ellenfel/solar_tracker_pcb/kicad_files/doc/screenshots/revd/3d-model-front.png

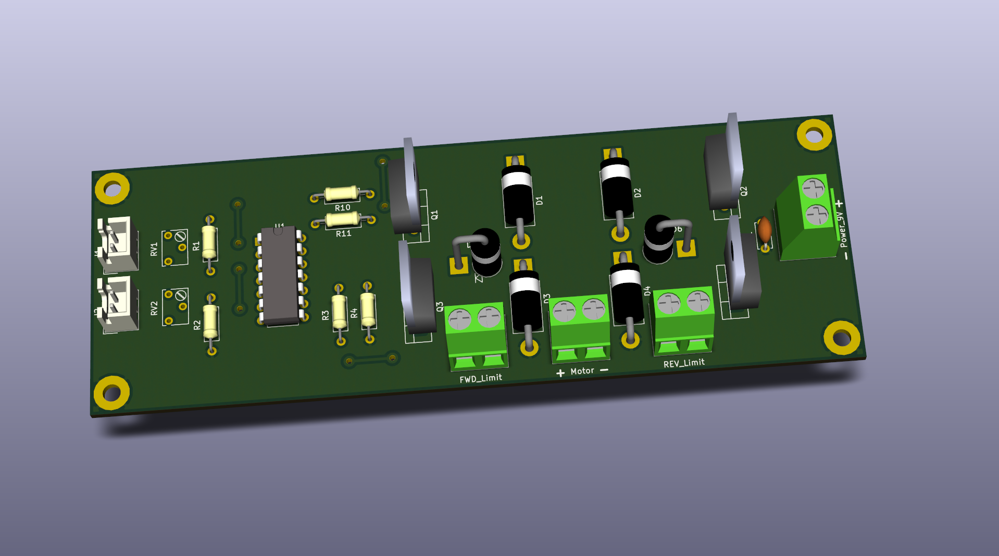
kicad_files/doc/screenshots/revd/3d-model-front.png
