ellenfel/solar_tracker_pcb/3d-model-bottom.png

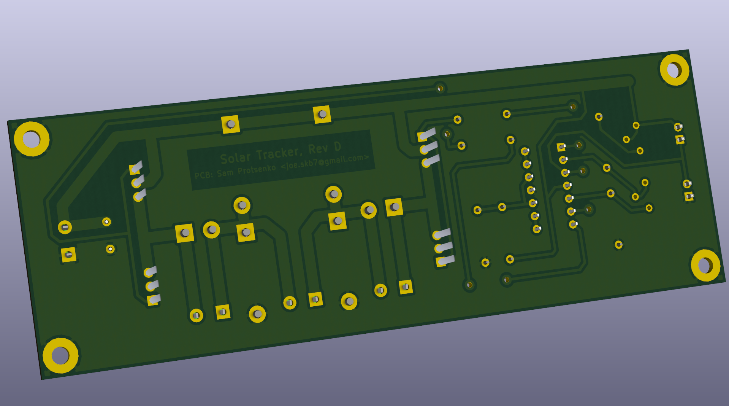
3d-model-bottom.png
