ellenfel/solar_tracker_pcb/diy_solar_tracker_schematic.png

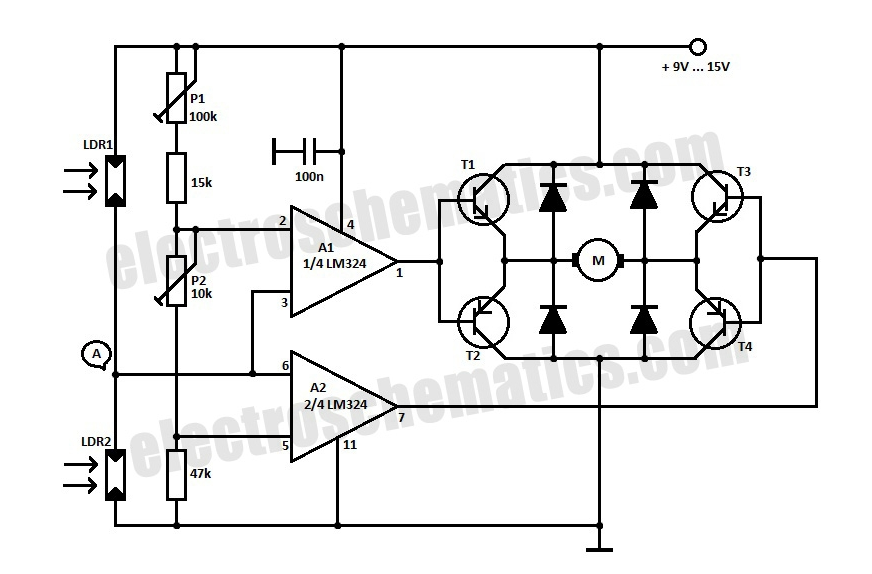
diy_solar_tracker_schematic.png
