ellenfel/solar_tracker_pcb/kicad_files/doc/limit-switch/limit-switch-1.png

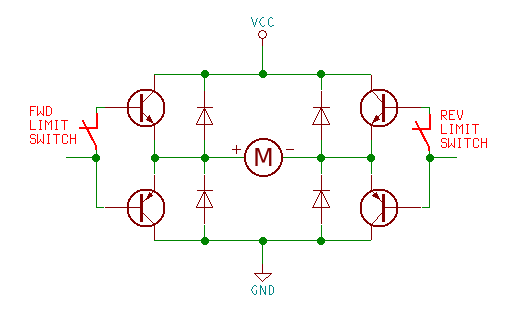
kicad_files/doc/limit-switch/limit-switch-1.png
