ellenfel/solar_tracker_pcb/kicad_files/doc/limit-switch/limit-switch-2.png

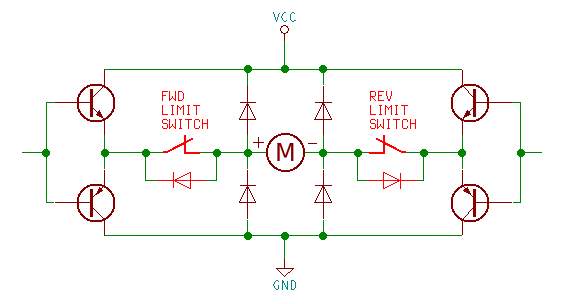
kicad_files/doc/limit-switch/limit-switch-2.png
