ellenfel/solar_tracker_pcb/kicad_files/doc/scheme.jpg

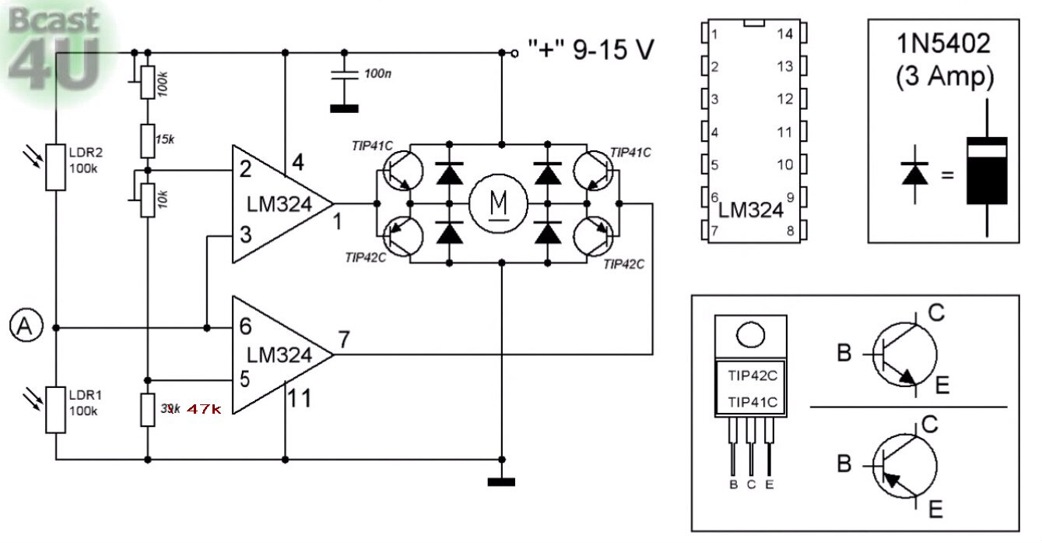
kicad_files/doc/scheme.jpg
