ellenfel/solar_tracker_pcb/kicad_files/doc/screenshots/revd/schematic.png

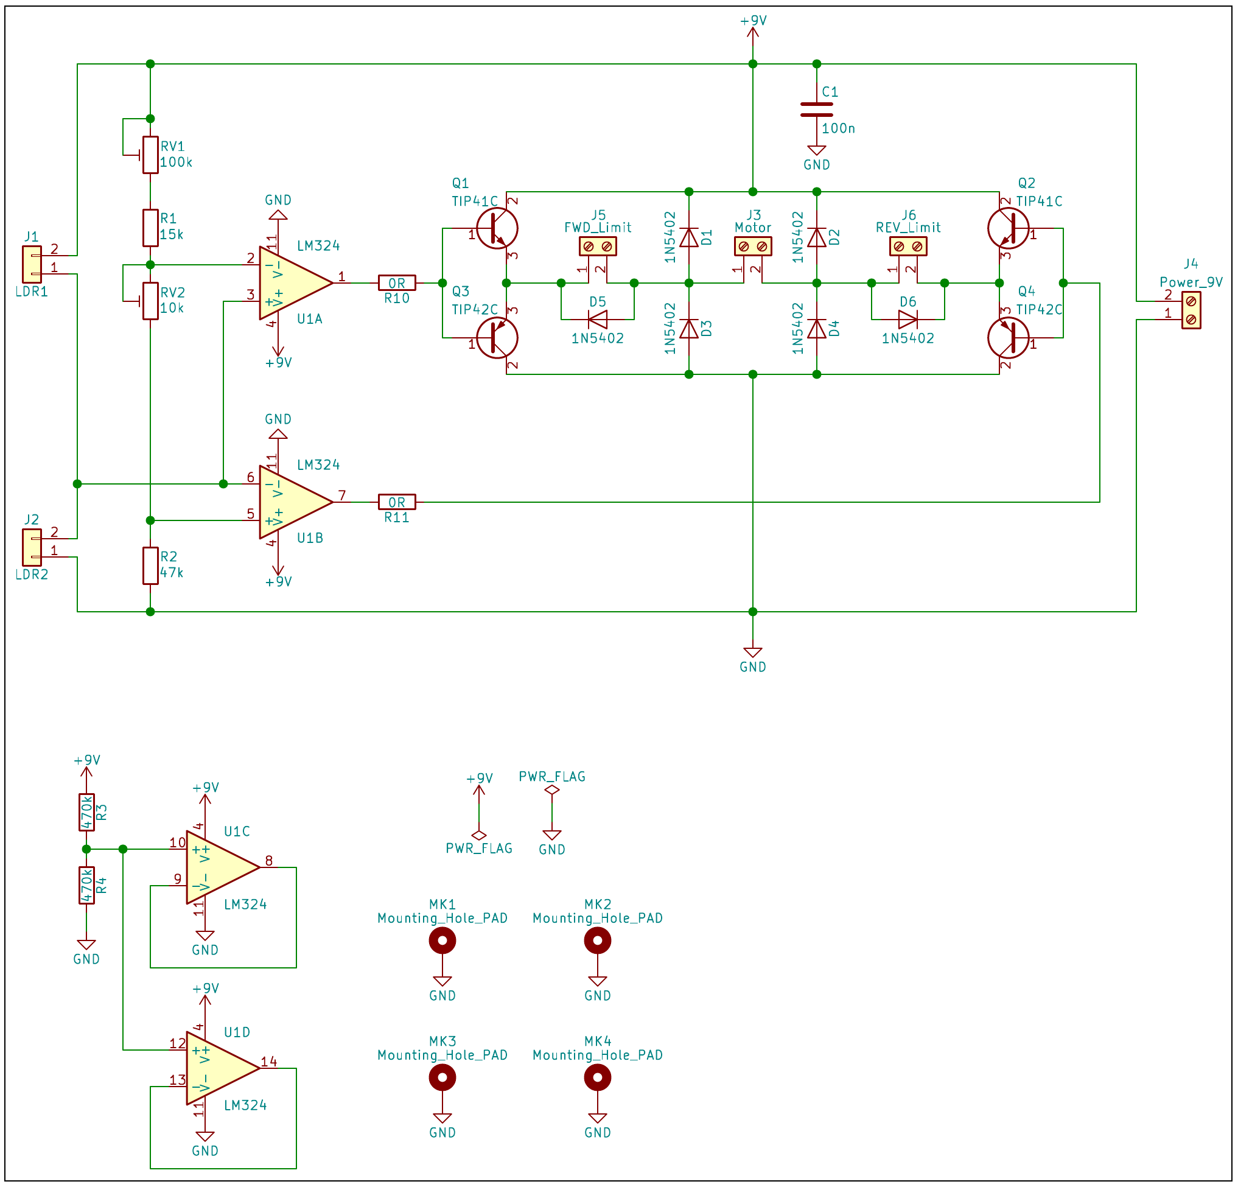
kicad_files/doc/screenshots/revd/schematic.png
