ellenfel/solar_tracker_pcb/Screenshot from 2024-11-24 20-09-38.png

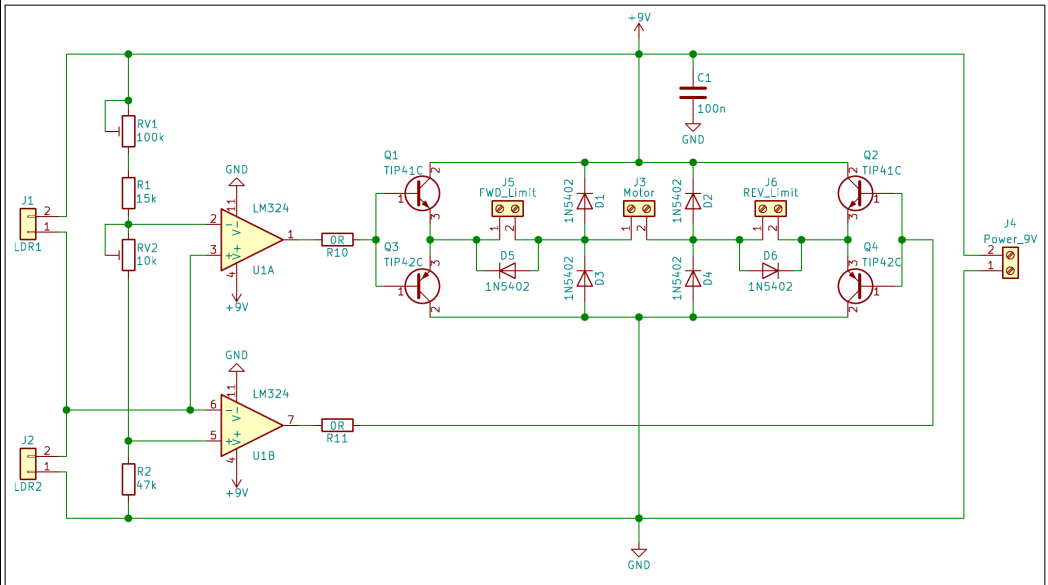
Screenshot from 2024-11-24 20-09-38.png
