ellenfel/solar_tracker_pcb/Screenshot from 2024-11-24 20-09-58.png

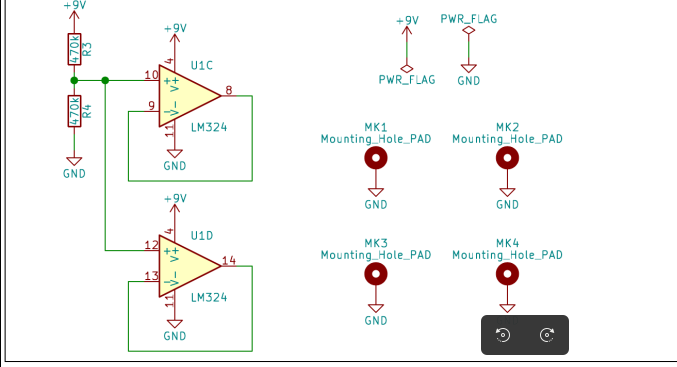
Screenshot from 2024-11-24 20-09-58.png
