ellenfel/solar_tracker_pcb/solar.png

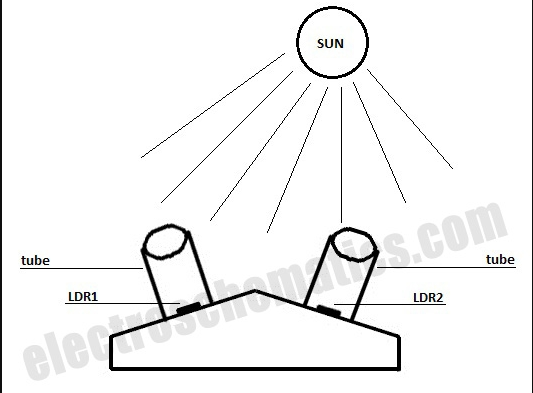
solar.png
