ellenfel/solar_tracker_pcb/kicad_files/out/revd/bom.pdf

solar-tracker

Id | Designator | Package | Quantity | Designation
1 C1 | | C_Disc_D5.0mm_W2.5mm_P5.00mm | 1 100n
2 D1-D6 | | D_DO-201AD_P15.24mm_Horizontal | 6
3 J1,J2 | | JST_XH_B02B-XH-A_02x2.50mm_Straight | 2
4 J3-J6 | | TerminalBlock_Pheonix_MKDS1.5-2pol | 4
5 Q1,Q2 | | TO-220_Vertical | 2 TIP41C
6 Q3,Q4 | | TO-220_Vertical | 2 TIP42C
7 R1 | | R_Axial_DIN0207_L6.3mm_D2.5mm_P10.16mm_Horizontal | 1 15k
8 R10,R11 | | R_Axial_DIN0207_L6.3mm_D2.5mm_P10.16mm_Horizontal | 2 0R
9 R2 | | R_Axial_DIN0207_L6.3mm_D2.5mm_P10.16mm_Horizontal | 1 47k
10 R3,R4 | | R_Axial_DIN0207_L6.3mm_D2.5mm_P10.16mm_Horizontal | 2 470k
11 RV1 | | Potentiometer_Trimmer_Bourns_3266W | 1 100k
12 RV2 | | Potentiometer_Trimmer_Bourns_3266W | 1 10k
13 U1 | | DIP-14_W7.62mm | 1 LM324
