ellenfel/solar_tracker_pcb/kicad_files/solar-tracker.kicad_pcb

## KiCad design kicad_files/solar-tracker.kicad_pcb (2024-11-24)

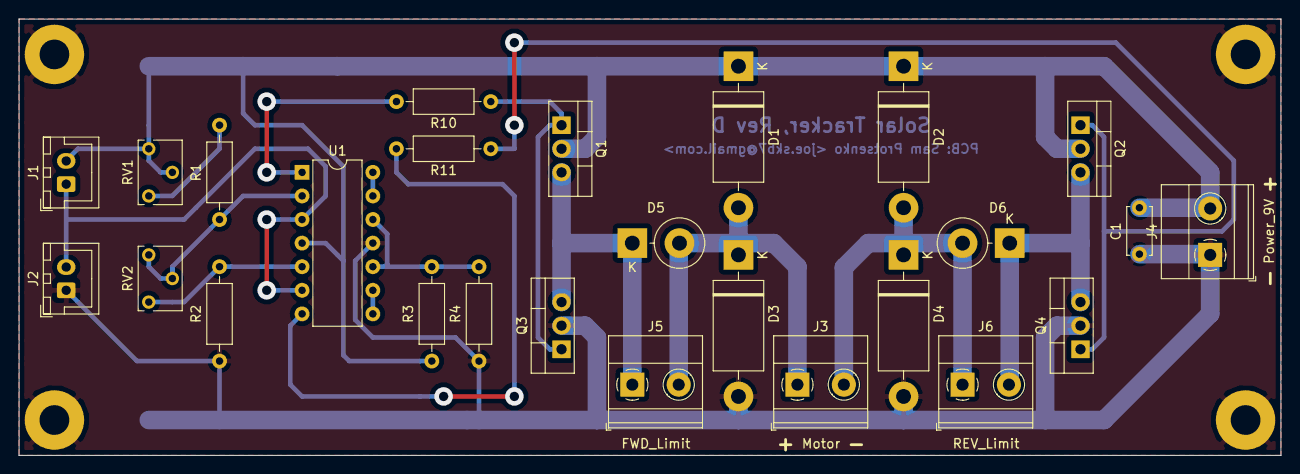
[picture p11: board solar-tracker.kicad_pcb from above]

Board: 2 copper layers, 135.9 x 47.0 mm, 30 parts (0 on the bottom side), 17 nets.

Parts:
C1: 100n; C_Disc_D5.0mm_W2.5mm_P5.00mm
D1, D2, D3, D4: 1N5402; D_DO-201AD_P15.24mm_Horizontal
D5, D6: 1N5402; D_DO-201AD_P5.08mm_Vertical_KathodeUp
J1: LDR1; JST_XH_B02B-XH-A_1x02_P2.50mm_Vertical
J2: LDR2; JST_XH_B02B-XH-A_1x02_P2.50mm_Vertical
J3: Motor; TerminalBlock_Phoenix_MKDS-1,5-2_1x02_P5.00mm_Horizontal
J4: Power_9V; TerminalBlock_Phoenix_MKDS-1,5-2_1x02_P5.00mm_Horizontal
J5: FWD_Limit; TerminalBlock_Phoenix_MKDS-1,5-2_1x02_P5.00mm_Horizontal
J6: REV_Limit; TerminalBlock_Phoenix_MKDS-1,5-2_1x02_P5.00mm_Horizontal
MK1, MK2, MK3, MK4: Mounting_Hole_PAD; MountingHole_3.2mm_M3_Pad
Q1, Q2: TIP41C; TO-220-3_Vertical
Q3, Q4: TIP42C; TO-220-3_Vertical
R1: 15k; R_Axial_DIN0207_L6.3mm_D2.5mm_P10.16mm_Horizontal
R2: 47k; R_Axial_DIN0207_L6.3mm_D2.5mm_P10.16mm_Horizontal
R3, R4: 470k; R_Axial_DIN0207_L6.3mm_D2.5mm_P10.16mm_Horizontal
R10, R11: 0R; R_Axial_DIN0207_L6.3mm_D2.5mm_P10.16mm_Horizontal
RV1: 100k; Potentiometer_Bourns_3266W_Vertical
RV2: 10k; Potentiometer_Bourns_3266W_Vertical
U1: LM324; DIP-14_W7.62mm

Connections:
+9V: C1.1, D1.1, D2.1, J1.2, J4.2, Q1.2, Q2.2, R3.1, RV1.1, RV1.2, U1.4
GND: C1.2, D3.2, D4.2, J2.1, J4.1, MK1.1, MK2.1, MK3.1, MK4.1, Q3.2, Q4.2, R2.2, R4.2, U1.11
unnamed: D1.2, D3.1, D5.2, J3.1, J5.2
unnamed: D2.2, D4.1, D6.2, J3.2, J6.1
unnamed: D5.1, J5.1, Q1.3, Q3.3
unnamed: D6.1, J6.2, Q2.3, Q4.3
unnamed: J1.1, J2.2, U1.3, U1.6
unnamed: Q1.1, Q3.1, R10.1
unnamed: Q2.1, Q4.1, R11.1
unnamed: R1.1, RV1.3
unnamed: R1.2, RV2.1, RV2.2, U1.2
unnamed: R2.1, RV2.3, U1.5
unnamed: R3.2, R4.1, U1.10, U1.12
unnamed: R10.2, U1.1
unnamed: R11.2, U1.7
unnamed: U1.8, U1.9
unnamed: U1.13, U1.14
