ellenfel/solar_tracker_pcb/(commit log)

2024-11-24 added schematic
2024-11-24 schematic done
    [solar-tracker-B.Cu.gbl, solar-tracker-B.Mask.gbs, solar-tracker-B.SilkS.gbo, solar-tracker-Edge.Cuts.gm1, solar-tracker-F.Cu.gtl, solar-tracker-F.Mask.gts, solar-tracker-F.SilkS.gto, solar-tracker.drl]
